STB3/K40_helper/K40_panel_V1.pdf

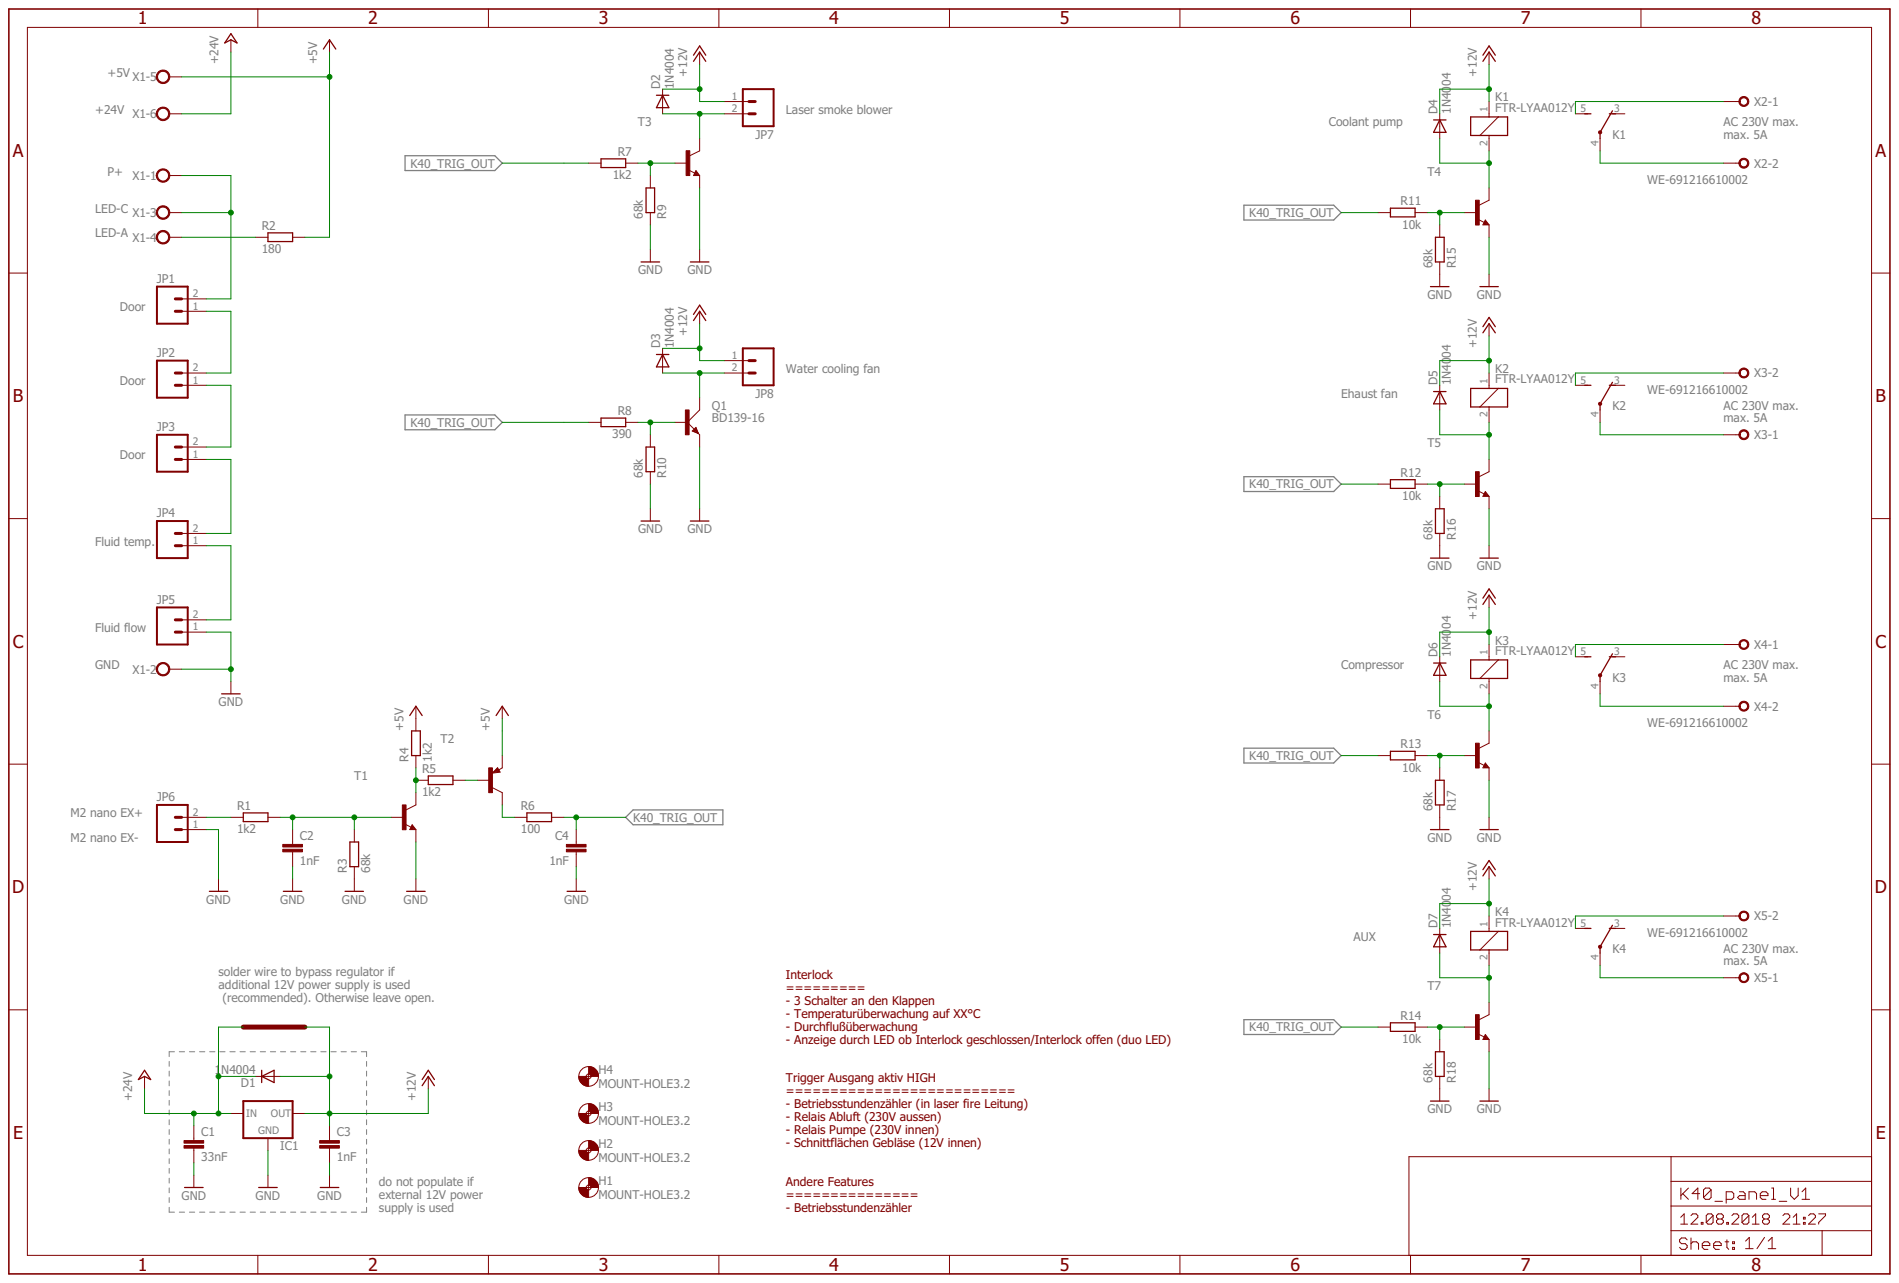
[picture p1: page 1]
