STB3/K40_helper/K40_panel_V1.brd

## EAGLE design K40_panel_V1.brd (2018-09-03)

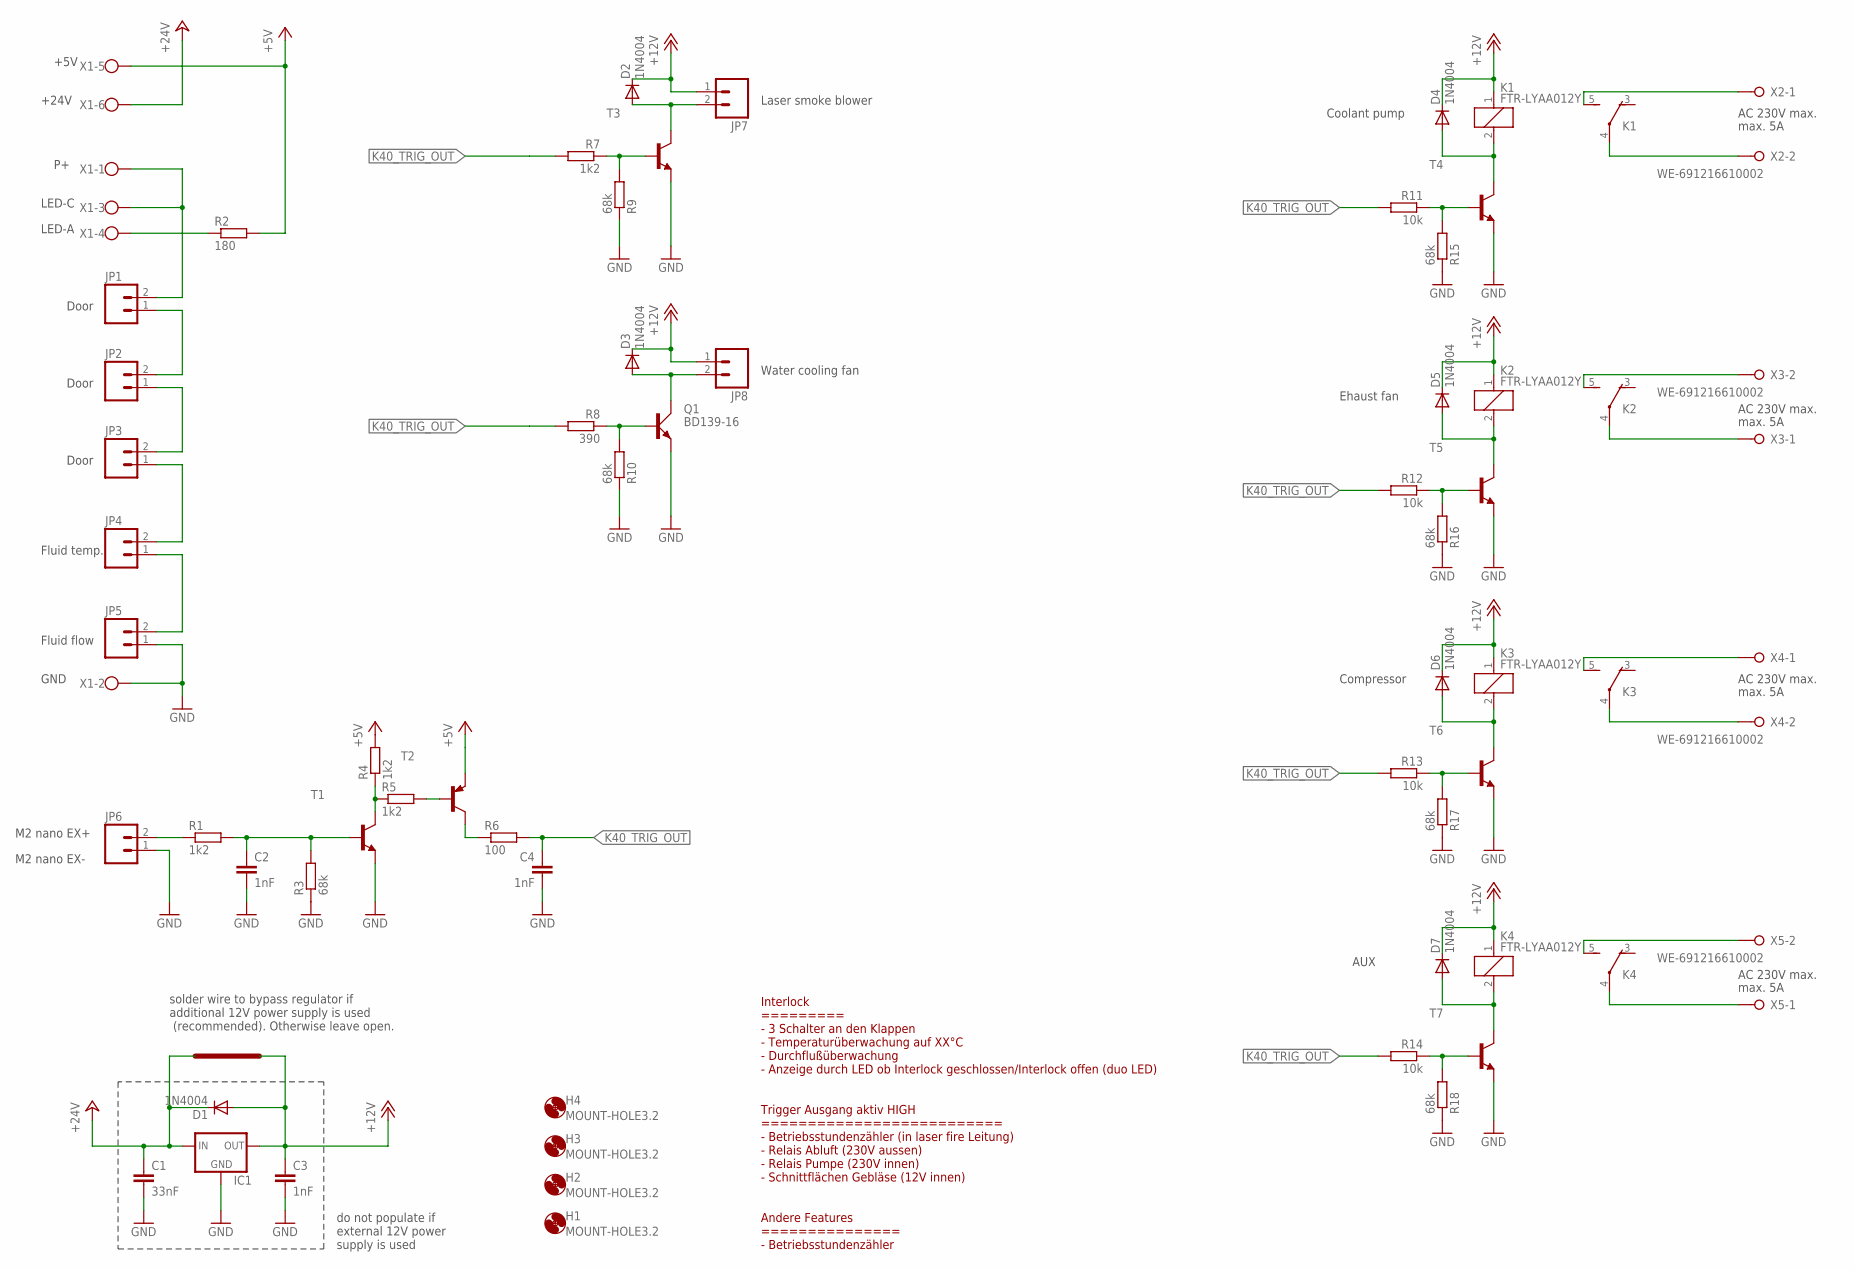
[picture p2: schematic K40_panel_V1.sch]

Parts:
C1: 33nF; C050-024X044
C2, C3, C4: 1nF; C050-024X044
D1, D2, D3, D4, D5, D6, D7: 1N4004; DO41-10
H1, H2, H3, H4: MOUNT-HOLE3.2; 3,2
IC1: 78XXS
JP1, JP2, JP3, JP4, JP5, JP6, JP7, JP8: M02POLAR; MOLEX-1X2
K1, K2, K3, K4: FTR-LYAA012Y; FTR-LYC
Q1: BD139-16; TO126AV
R1, R4, R5, R7: 1k2; 0204/7
R2: 180; 0204/7
R3, R9, R10, R15, R16, R17, R18: 68k; 0204/7
R6: 100; 0204/7
R8: 390; 0204/7
R11, R12, R13, R14: 10k; 0204/7
T1, T3, T4, T5, T6, T7: 2N4401-NPN-TO92-EBC; TO92-EBC
T2: 2N4403-PNP-TO92-EBC; TO92-EBC
X1: W237-6
X2, X3, X4, X5: WE-691216610002; W237-2N

Connections:
+5V: R2.2, R4.2, T2.E, X1.5
+12V: C3.1, D1.A, D2.C, D3.C, D4.C, D5.C, D6.C, D7.C, IC1.OUT, JP7.1, JP8.1, K1.1, K2.1, K3.1, K4.1
+24V: C1.1, D1.C, IC1.IN, X1.6
GND: C1.2, C2.2, C3.2, C4.2, IC1.GND, JP5.1, JP6.1, Q1.E, R3.1, R9.1, R10.1, R15.1, R16.1, R17.1, R18.1, T1.E, T3.E, T4.E, T5.E, T6.E, T7.E, X1.2
K40_TRIG_OUT: C4.1, R6.2, R7.2, R8.2, R11.2, R12.2, R13.2, R14.2
unnamed: JP1.2, X1.1, X1.3
unnamed: JP1.1, JP2.2
unnamed: JP2.1, JP3.2
unnamed: JP3.1, JP4.2
unnamed: JP4.1, JP5.2
unnamed: JP6.2, R1.1
unnamed: R2.1, X1.4
unnamed: C2.1, R1.2, R3.2, T1.B
unnamed: R4.1, R5.1, T1.C
unnamed: D2.A, JP7.2, T3.C
unnamed: R7.1, R9.2, T3.B
unnamed: D6.A, K3.2, T6.C
unnamed: R5.2, T2.B
unnamed: R6.1, T2.C
unnamed: R13.1, R17.2, T6.B
unnamed: K1.4, X2.2
unnamed: D7.A, K4.2, T7.C
unnamed: D4.A, K1.2, T4.C
unnamed: D5.A, K2.2, T5.C
unnamed: R14.1, R18.2, T7.B
unnamed: K1.5 (S), X2.1
unnamed: R11.1, R15.2, T4.B
unnamed: K2.5 (S), X3.2
unnamed: K2.4, X3.1
unnamed: R12.1, R16.2, T5.B
unnamed: K3.5 (S), X4.1
unnamed: K3.4, X4.2
unnamed: K4.5 (S), X5.2
unnamed: K4.4, X5.1
unnamed: D3.A, JP8.2, Q1.C
unnamed: Q1.B, R8.1, R10.2

Notes on the sheet:
Interlock ========= - 3 Schalter an den Klappen - Temperaturüberwachung auf XX°C - Durchflußüberwachung - Anzeige durch LED ob Interlock geschlossen/Interlock offen (duo LED) Trigger Ausgang aktiv HIGH ========================== - Betriebsstundenzähler (in laser fire Leitung) - Relais Abluft (230V 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
Door
Fluid temp.
Fluid flow
GND
LED-C
+5V
LED-A
+24V
Laser smoke blower
Coolant pump
Ehaust fan
Compressor
AUX
max. 5A
AC 230V max.
Water cooling fan
solder wire to bypass regulator if additional 12V power supply is used (recommended). Otherwise leave open.
do not populate if external 12V power supply is used
M2 nano EX+
M2 nano EX-

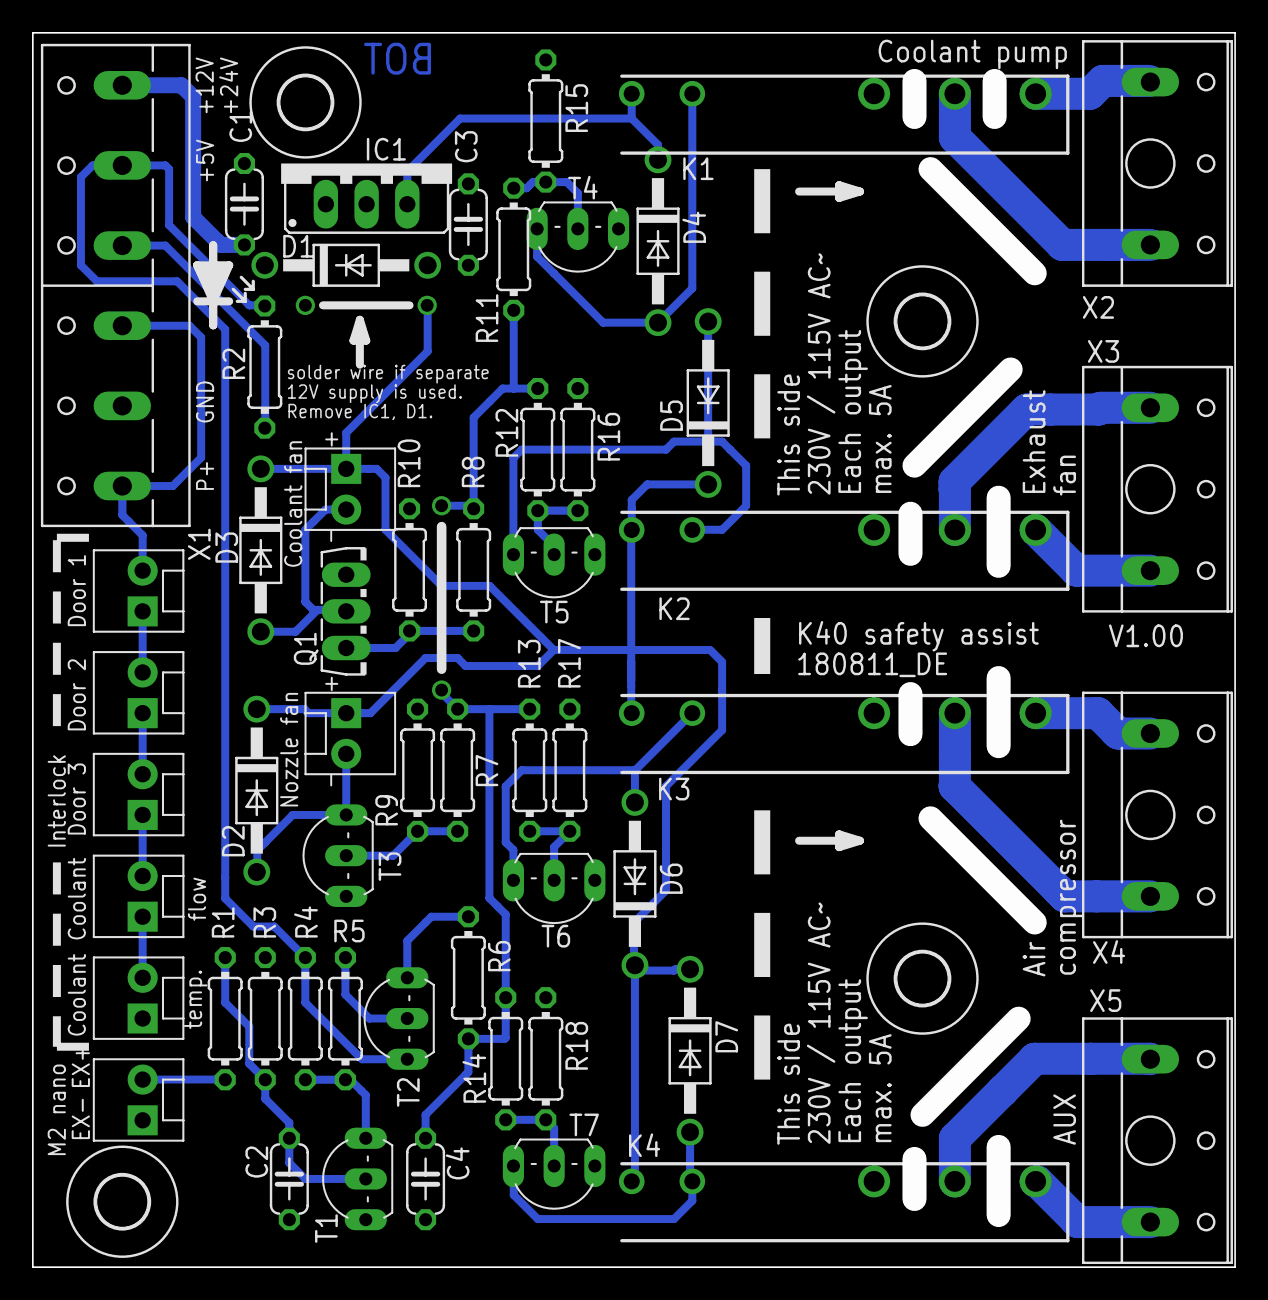
[picture p3: board K40_panel_V1.brd from above]

Board: 1 copper layer, 75.0 x 77.0 mm, 59 parts (0 on the bottom side), 36 nets.
