STB3/K40_helper/K40_helper_wiring.png

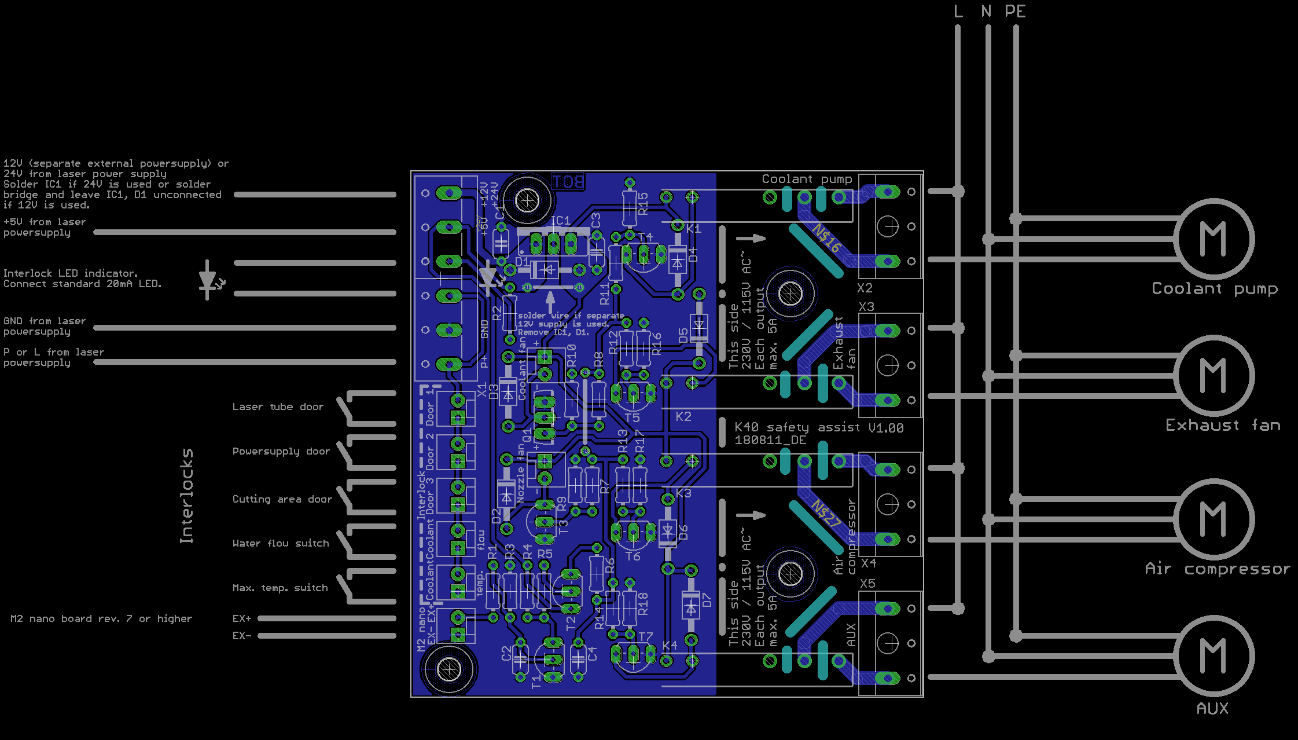
K40_helper_wiring.png
