STB3/K40_helper/(threads)

Thread 1 (2018-11-17):

Your mail address is no longer valid

RF3, 2018-11-17:
I would like to contact you for a question about the USB Optolink adapter for Viessmann heating, but your special mail address at bytelink.de doesn't work anymore as this domain is no longer in use. Also, the address used for this github account is no longer working for the same reason.

STB3, 2018-11-17:
Hi!
I need your shipping address.
Then I’ll send you an invoice, after I received the payment the adapter will be shipped.
- 29,80€ USB-Adapter
- 10,20€ housing 3D printed
-  8€ shipping

Please select what you need.

Regards,
Dirk

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

RF3, 2018-11-17:
Hallo Dirk,
gibt es die schmale Variante mit CH340G auch mit Gehäuse statt Halter? Das wäre eigentlich meine erste Wahl.
Ich würde meine Anschrift lieber per E-Mail übermitteln und nicht öffentlich über github.

STB3, 2018-11-17:
Hi!

Die CH340 Variante ist vergriffen und es gibt aktuell keinen Plan sie neu aufzulegen. Die Nachfrage ist minimal.

Grüße

Dirk Eichel

optolink@avboard.de <mailto:optolink@avboard.de>

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

RF3, 2018-11-17:
Danke. Ich habe meine Bestellung an info@avboard.de geschickt, da optolink@avboard.de auch nicht funktioniert.

Bascht74, 2023-11-05:
Hallo Dirk,

ich hätte auch Interesse an einem Interface für meine Viessmann Gas-Heizung.
Gibt es so etwas noch?

Am liebsten würde ich es gleich mit einem ESP32 betreiben...

Ich bin gespannt! Der letzte Eintrag dazu ist ja immerschin schon 5 Jahr eher.

STB3, 2023-11-06:
Hallo,

zu Deiner Frage: „Am liebsten würde ich es gleich mit einem ESP32 betreiben...“

Nein, das Teil unterstützt nur USB.

Bei Interesse bitte eine E-Mail mit Adresse, der Anzahl und dem Lieferumfang (mit/ohne Gehäuse) bestellter Adapter.

Zahlung per PayPal an ***@***.***

Die Preise:

•             Optolink Adapter (neue Version)             21,- €

•             Gehäuse für neuen Adapter                      5,- €

•             Versandkosten (Deutschland)                    3,- € (unversichert) / 6,- € (versichert & tracking)

Der Versand fällt bei mehreren Adaptern nur 1x an.

Versand ins Ausland nach Aufwand.

Grüße

Dirk

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
