STB3/K40_helper/(commit log)

2018-09-03 Initial version
    [K40_panel_V1.brd, K40_panel_V1.sch]
2018-09-03 Add BOM
